UsefHendawy/Battery-Telemetry-DSP-Project/(commit log)

2026-07-01 Edited Voltage Divider Math
2026-07-01 Fixed Voltage reading code
2026-07-03 Machine Learning code and data set file
    [telemetry_features_db.csv]
2026-07-03 Dual voltage path update
2026-07-03 9V path update and data
    [telemetry_features_db.csv]
2026-07-26 Update telemetry features dataset
    [telemetry_features_db.csv]
2026-07-27 Update telemetry logger and multi-class feature database
    [telemetry_features_db.csv]
2026-08-03 Updated dataset collection across battery profiles
    [telemetry_features_db.csv]
2026-08-03 Implement scikit-learn battery classification training pipeline
2026-08-11 Coin battery, supercapacitor and AAA zinc carbon data
2026-08-23 dashboard log
    [telemetry_run_log.csv]
2026-08-24 new name for log files from bp harvester
    [bp_log.csv]
2026-08-24 updated dashboard
    [dashboard_log.csv]
2026-08-29 Updated Readme and overall project posting
    [nasa_battery_processed.csv]
2026-08-30 Full project release
    [dashboard_log.csv, metadata.csv, telemetry_features_db.csv, telemetry_run_log.csv]
2026-08-30 Final Tweaks
    [dashboard_log.csv]
2026-08-30 README.typo fixed
    [dashboard_log.csv]
2026-08-30 Final upload
    [dashboard_log.csv]
